define-struct-union/audi_concert1_chorus1_volume_fix/README.md

> ## ⚠️ v2.0.0 — Important notice
>
> **Firmware v2.0.0 is only suitable for HWv5 boards.** It will NOT work correctly on older hardware revisions (v1–v4).
>
> This release is currently **under real-life / daily-use testing**. If you experience issues, please open a [GitHub issue](https://github.com/tomaskovacik/audi_concert1_chorus1_volume_fix/issues).
>
> ### What changed in v2.0.0 (not in release notes — no PRs were used)
>
> - **Switched to official STMicroelectronics STM32 Arduino core** (replaces Roger Clark's libmaple/stm32duino community core)
> - **Hardware SPI** used for front-panel communication (via STM32 core SPI peripheral)
> - **FlexWire** software I2C library used for TDA7342 volume chip communication on PB10/PB11  
>   (STM32F103C6 has only one I2C peripheral; hardware I2C2 does not exist on this chip)
> - **Persistent config** saved to last flash page (volume level, GALA, TA) — replaces EEPROM emulation from older cores
> - **GALA** (speed-dependent volume) support via VSS pulse timing on PB5
> - **CI** updated to build and release firmware binary automatically on git tags

Software and hardware to fix volume problem on audi concert1/chorus1 units made by blaupunkt. More about this problem in [this](https://github.com/tomaskovacik/audi_concert1_chorus1_volume_fix/wiki/Problem-of-Some-AUDI-Chorus-and-AUDI-Concert-Autoradio-Models,-or-%22Delayed-Action-Mine%22-from-Blaupunkt-Company) wiki page which is copy from [here](https://web.archive.org/web/20071017195907/http://erta.ru/review/chorus-problem_eng.shtml).

#### Compatible radios:

These are 100% compatible, manufactured by Blaupunkt:
```
Audi Chorus - 7 646 243 380 (4B0 035 152)
Audi Chorus A8 - 7 647 243 380
Audi Concert - 7 646 248 380 (4B0 035 186)
Audi Concert A8 - 7 647 248 380 (4D0 035 186A)
Audi Concert Navi - 7 647 249 380 (4B0 035 186B)
AUDI	CONCERT TT AUZ1Z3	7 648 244 380 (4B0 035 186D)
```
Maybe for these, drop me a message with pictures of radio from outside and inside, and I can check if your radio is compatible with this module:
```
AUDI	CHORUS A3	7 640 251 380
AUDI	CHORUS A8	7 648 243 380
AUDI	CHORUS AUZ1Z2	7 647 245 380   4B0 035 152A
AUDI	CHORUS M4 AUZ1Z2	7 648 245 380   4B0 035 152B
AUDI	CHORUS M4 AUZ1Z2	7 648 245 380   4B0 035 152B
AUDI	CONCERT A8	7 648 248 380
AUDI	CONCERT M4 AUZ1Z3	7 648 247 380   4B0 035 186C
```
#### Not compatible radios

Audio Concert made by Panasonic/Matsushita (8L0 035 186A, possible other codes ).This radio from this manufacturer did not have problems with volume (if it has, the problem is in volume rotary encoder)

There are other radios manufactured by Blaupunkt called Audi Concert Plus, which are not compatible:
```
AUDI	CONCERT PLUS AUZ1Z3	7 649 246 380   4B0 035 186E
AUDI	CONCERT PLUS A8 AUZ1Z3	7 649 249 380   4D0 035 186F
```
These use a different design and so are not compatible with this module. I never read that these radios did have a volume problem. If there is one then it is most likely a problem with volume rotary encoder.

#### Issues
Known issues <a href="https://github.com/tomaskovacik/audi_concert1_chorus1_volume_fix/issues">are here</a>

#### Video
Module in action: 

#### Schematics:



Schematics in <a href="https://github.com/tomaskovacik/audi_concert1_chorus1_volume_fix/blob/master/HW/audi_concert1_chorus1_volume_fix/audi_concert1_chorus1_volume_fix.pdf">pdf</a>.

Assemble plan for latest v5 is <a href="https://tomaskovacik.github.io/audi_concert1_chorus1_volume_fix/HW/audi_concert1_chorus1_volume_fix/bom_v5/ibom.html">here</a>. Components with value prefi NP_ are not required (not populated). These are there for future features. 1k_GALA resistor has to be populated if SW with <a href="https://github.com/tomaskovacik/audi_concert1_chorus1_volume_fix/blob/gala/SW/audi_volume_fix_stm32/audi_volume_fix_stm32.ino">gala</a> support is used (SW from gala branch). AP for old v1 hw is <a href="https://raw.githubusercontent.com/tomaskovacik/audi_concert1_chorus1_volume_fix/master/HW/audi_concert1_chorus1_volume_fix/assemble_plan1_0.png">here</a>.

Gerbers, BOM and pick & place files for ordering the v5 board, plus a step-by-step build guide, are in [HW/fab_v5](HW/fab_v5/README.md).

Pictures of finished product:









Bottom side, with PLCC52 socket, inside part of pastic need to be cut:



Upper side, with comments to sockets



How to wire it (currently without intefacing with front pannel)



# COPYING

Everything is under GPLv3

# CONTRIBUTION

Contributions are welcome

# PCBs

PCBs are on sale also as whole product, kitt (PCB, soldered crystals, unsoldered preprogramed IC, pasives,PLCC52 socket)
