define-struct-union/audi_concert1_chorus1_volume_fix/HW/fab_v5/bom_readable.txt

Audi Concert1/Chorus1 volume fix - HW v5
Board outline: 33.0 x 27.2 mm, 2 layers, assembly top side only

=== MACHINE-PLACED (23 parts, 11 lines) ===
 10x  1k                                 0805                         R1,R3,R4,R5,R6,R7,R8,R11,R20,R23
  2x  100n                               0805                         C6,C7
  2x  22p                                0805                         C4,C5
  2x  47k                                0805                         R9,R10
  1x  10k                                0805                         R21
  1x  1M                                 0805                         R18
  1x  3k3                                0805                         R2
  1x  8MHz crystal SMD5032-4P 20pF       SMD 5032 (5.0x3.2mm, 4 pad)  Y2
  1x  AMS1117-3.3                        SOT-223                      U2
  1x  LED red 1206                       1206                         D1
  1x  STM32F103C8T6                      LQFP-48 7x7 0.5mm            U3

=== YOU FIT BY HAND ===
  1x  PLCC-52 socket, SMD, 1.27mm        U1   (clamps onto radio's 68HC05)
  1x  pin header 1x2, 2.54mm             CON1 (1=SCL_TO_TDA, 2=SDA_TO_TDA)
  1x  pin header 1x3, 2.54mm             CON3 (1=DATA, 2=STATUS, 3=CLOCK to panel)
  1x  pin header 1x6, 2.54mm             CON4 (1=GND 2=SWDCLK 3=SWDIO 4=3V3 5=RX 6=TX)
      solder blob                        JP1/JP2 boot jumpers -> bridge to GND side

=== LEAVE EMPTY (not populated in v5) ===
  C2     12p(NP)
  C3     12p(NP)
  C8     10u/16V
  R12    20(NP)
  R13    20(NP)
  R14    1k5(NP)
  R15    1k(NP)
  R16    1k(NP)
  R17    1k(NP)
  R19    1k(NP)
  R22    10k(NP)
  R24    1k(NP)
  U4     MAX809(NP)
  Y1     32.768kHz(NP)
