define-struct-union/audi_concert1_chorus1_volume_fix/HW/fab_v5/bom_jlcpcb.csv

Comment | Designator | Footprint | Quantity | LCSC Part #
1k | R1,R3,R4,R5,R6,R7,R8,R11,R20,R23 | 0805 | 10 | C17513
100n | C6,C7 | 0805 | 2 | C49678
22p | C4,C5 | 0805 | 2 | C1804
47k | R9,R10 | 0805 | 2 | C17713
10k | R21 | 0805 | 1 | C17414
1M | R18 | 0805 | 1 | C17514
3k3 | R2 | 0805 | 1 | C26010
8MHz crystal SMD5032-4P 20pF | Y2 | SMD 5032 (5.0x3.2mm, 4 pad) | 1 | C3003245
AMS1117-3.3 | U2 | SOT-223 | 1 | C6186
LED red 1206 | D1 | 1206 | 1 | C965822
STM32F103C8T6 | U3 | LQFP-48 7x7 0.5mm | 1 | C8734
