define-struct-union/audi_concert1_chorus1_volume_fix/HW/fab_v5/preview_top.pdf

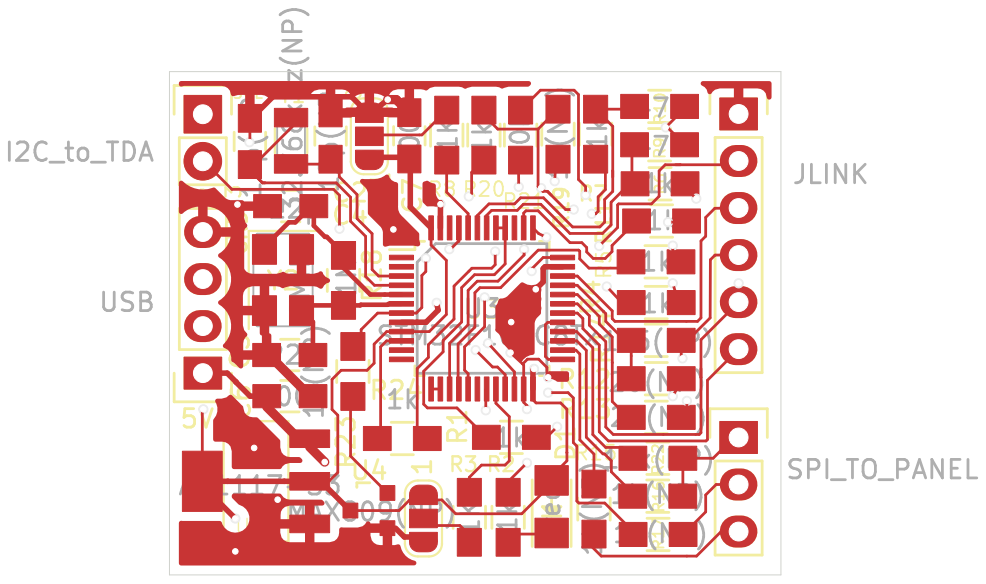
[picture p1: page 1]
