define-struct-union/audi_concert1_chorus1_volume_fix/HW/audi_concert1_chorus1_volume_fix/audi_concert1_chorus1_volume_fix.kicad_pcb

## KiCad design HW/audi_concert1_chorus1_volume_fix/audi_concert1_chorus1_volume_fix.kicad_pcb (2026-11-10)

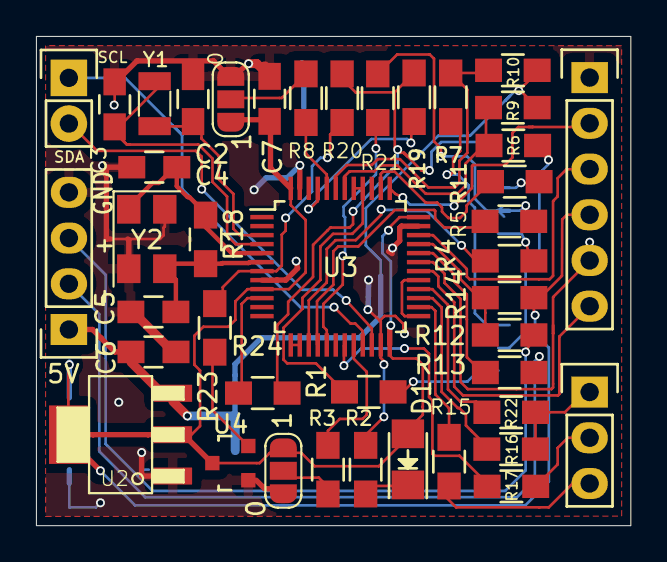
[picture p2: board audi_concert1_chorus1_volume_fix.kicad_pcb from above]

Board: 2 copper layers, 33.0 x 27.2 mm, 44 parts (1 on the bottom side), 49 nets.

Parts:
C2, C3: 12p(NP); C_0805_HandSoldering
C4, C5: 22p; C_0805_HandSoldering
C6, C7: 100n; C_0805_HandSoldering
C8: 10u/16V; TantalC_SizeA_EIA-3216_HandSoldering
CON1: I2C_to_TDA; Pin_Header_Straight_1x02
CON2: USB; Pin_Header_Straight_1x04
CON3: SPI_TO_PANEL; Pin_Header_Straight_1x03
CON4: JLINK; Pin_Header_Straight_1x06
D1: red; LED-1206
JP1, JP2: SolderJumper_3_Open; SolderJumper-3_P1.3mm_Open_RoundedPad1.0x1.5mm_NumberLabels
R1, R2, R4, R5, R6, R7, R11, R20, R23: 1k; R_0805_HandSoldering
R3, R8: 1K; R_0805_HandSoldering
R9, R10: 47k; R_0805_HandSoldering
R12, R13: 20(NP); R_0805_HandSoldering
R14: 1k5(NP); R_0805_HandSoldering
R15, R16, R17, R19, R24: 1k(NP); R_0805_HandSoldering
R18: 1M; R_0805_HandSoldering
R21: 10k; R_0805_HandSoldering
R22: 10k(NP); R_0805_HandSoldering
U1: 68HC05_PLCC; PLCC-52_mirrored
U2: AP1117-33; AB2_SOT223
U3: STM32F103C8Tx; LQFP-48_7x7mm_Pitch0.5mm
U4: MAX809(NP); SOT-23
Y1: 32.768kHz(NP); Crystal_SMD_3215-2pin_3.2x1.5mm
Y2: 8MHz; Crystal_SMD_5032-4pin_5.0x3.2mm

Connections:
3V3: C7.1, C8.1, CON4.4, D1.2 (A), JP1.3 (B), JP2.3 (B), R14.1, U2.2 (VO), U3.9 (VDDA), U3.24 (VDD), U3.36 (VDD), U3.48 (VDD), U4.3 (VCC)
5V: C6.1, CON2.1, R9.1, R10.2, U1.10 (VDD), U2.3 (VI)
/#STATUS_FROM_MCU: U3.13 (ADC1_IN3/ADC2_IN3/TIM2_CH4/USART2_RX/PA3), U3.14 (ADC1_IN4/ADC2_IN4/SPI1_NSS/USART2_CK/PA4)
/#STATUS_TO_PANEL: U3.25 (PB12/I2C2_SMBA/SPI2_NSS/TIM1_BKIN/USART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), U3.29 (RCC_MCO/TIM1_CH1/USART1_CK/PA8)
/BOOT0: JP1.2 (C), R8.2
/BOOT1: JP2.2 (C), R3.2
/CLOCK_FROM_MCU: R4.2, U1.29 (PA2)
/CLOCK_TO_PANEL: CON3.3, R15.1
/DATA_FROM_MCU: R5.1, R21.1, U1.30 (PA1)
/DATA_TO_PANEL: CON3.1, R16.1, R22.1
/GALA: R1.1, U1.23 (TCAP2)
/OSC32IN: C2.1, U3.3 (PC14/RCC_OSC32_IN), Y1.1
/OSC32OUT: C3.2, U3.4 (PC15/ADC1_EXTI15/ADC2_EXTI15/RCC_OSC32_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), Y1.2
/OSCIN: C4.1, R18.2, U3.5 (PD0/RCC_OSC_IN), Y2.1
/OSCOUT: C5.2, R18.1, U3.6 (PD1/RCC_OSC_OUT), Y2.3
/RESET: R20.2, R24.1, U3.7 (NRST)
/RESET_KA: R19.1, R20.1, R23.1, U1.33 (PB6)
/RX: CON4.5, U3.31 (TIM1_CH3/USART1_RX/PA10)
/SCL_FROM_MOTO: R6.2, U1.24 (PA7)
/SCL_TO_TDA: CON1.1, U3.21 (PB10/I2C2_SCL/TIM2_CH3/USART3_TX)
/SDA_FROM_MOTO: R7.2, U1.25 (PA6)
/SDA_TO_TDA: CON1.2, U3.22 (PB11/ADC1_EXTI11/ADC2_EXTI11/I2C2_SDA/T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)
/STATUS_FROM_MCU: R11.2, U1.31 (PA0)
/STATUS_TO_PANEL: CON3.2, R17.1
/SWDCLK: CON4.2, U3.37 (SYS_JTCK-SWCLK/PA14)
/SWDIO: CON4.3, U3.34 (SYS_JTMS-SWDIO/PA13)
/TX: CON4.6, U3.30 (TIM1_CH2/USART1_TX/PA9)
/USB+: R12.1, R14.2, U3.33 (CAN_TX/TIM1_ETR/USART1_RTS/USB_DP/PA12)
/USB-: R13.2, U3.32 (ADC1_EXTI11/ADC2_EXTI11/CAN_RX/TIM1_CH4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)
GND: C2.2, C3.1, C4.2, C5.1, C6.2, C7.2, C8.2, CON2.4, CON4.1, JP1.1 (A), JP2.1 (A), R2.1, U1.41 (VSS), U2.1 (GND), U3.8 (VSSA), U3.23 (VSS), U3.35 (VSS), U3.47 (VSS), U4.1 (GND), Y2.2, Y2.4
unnamed: CON2.2, R13.1
unnamed: CON2.3, R12.2
unnamed: D1.1 (K), R2.2
unnamed: R1.2, U3.40 (PB4/SPI1_MISO/SYS_NJTRST/TIM3_CH1), U3.41 (PB5/I2C1_SMBA/SPI1_MOSI/TIM3_CH2)
unnamed: R3.1, U3.20 (PB2/BOOT1)
unnamed: R4.1, U3.15 (ADC1_IN5/ADC2_IN5/SPI1_SCK/PA5)
unnamed: R5.2, U3.16 (ADC1_IN6/ADC2_IN6/SPI1_MISO/TIM1_BKIN/T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)
unnamed: R6.1, R9.2, U3.42 (PB6/I2C1_SCL/TIM4_CH1/USART1_TX)
unnamed: R8.1, U3.44 (BOOT0)
unnamed: R7.1, R10.1, U3.43 (PB7/I2C1_SDA/TIM4_CH2/USART1_RX)
unnamed: R11.1, U3.38 (ADC1_EXTI15/ADC2_EXTI15/SPI1_NSS/SYS_JT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)
unnamed: R15.2, U3.26 (PB13/SPI2_SCK/TIM1_CH1N/USART3_CTS)
unnamed: R16.2, U3.27 (PB14/SPI2_MISO/TIM1_CH2N/USART3_RTS)
unnamed: R17.2, U3.19 (PB1/ADC1_IN9/ADC2_IN9/TIM1_CH3N/TIM3_CH4)
unnamed: R19.2, U3.45 (PB8/CAN_RX/I2C1_SCL/TIM4_CH3)
unnamed: R21.2, U3.17 (ADC1_IN7/ADC2_IN7/SPI1_MOSI/TIM1_CH1N/T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)
unnamed: R22.2, U3.28 (PB15/ADC1_EXTI15/ADC2_EXTI15/SPI2_MOSI/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)
unnamed: R23.2, U3.10 (ADC1_IN0/ADC2_IN0/SYS_WKUP/TIM2_CH1/TIM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)
unnamed: R24.2, U4.2 (RESET)
