define-struct-union/audi_concert1_chorus1_volume_fix/(commit log)

2026-11-10 fix(hw): thin v5 board outline stroke to 0.05 mm
    The Edge.Cuts lines were drawn 1 mm wide, which plots a wide outline in the gerbers.
    [audi_concert1_chorus1_volume_fix.kicad_pcb]
2026-11-10 feat(hw): add v5 fabrication files and build guide
    Add gerbers, JLCPCB BOM and pick & place files, the scripts that generate
    them, a shopping list and a build guide. The gerbers already in the HW
    folder are from an older board revision.
    [audi_concert1_chorus1_volume_fix-B_Cu.gbr, audi_concert1_chorus1_volume_fix-B_Mask.gbr, audi_concert1_chorus1_volume_fix-B_Silkscreen.gbr, audi_concert1_chorus1_volume_fix-Edge_Cuts.gbr, audi_concert1_chorus1_volume_fix-F_Cu.gbr, audi_concert1_chorus1_volume_fix-F_Mask.gbr, audi_concert1_chorus1_volume_fix-F_Paste.gbr, audi_concert1_chorus1_volume_fix-F_Silkscreen.gbr]
